Boldestfutura/tab-panel/tab-panel-bezel.stl

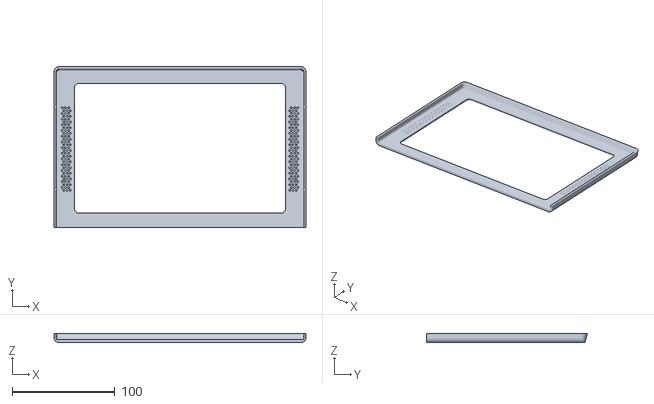
[picture p5: CAD file, 2026-10-31]
tab-panel-bezel.stl
245.0 x 156.4 x 9.00
