Boldestfutura/tab-panel/tab-panel-coupon.stl

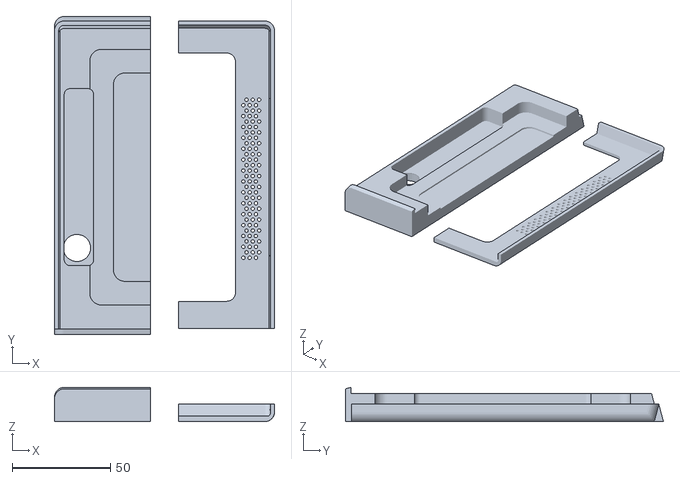
[picture p6: CAD file, 2026-10-31]
tab-panel-coupon.stl
112.0 x 161.7 x 17.5
