Boldestfutura/tab-panel/tab-panel-body.stl

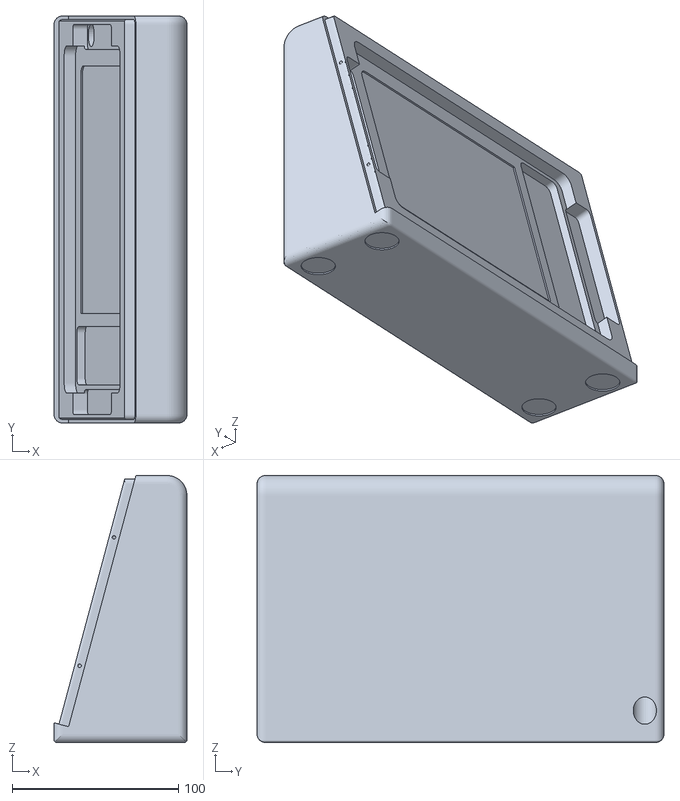
[picture p7: CAD file, 2026-10-31]
tab-panel-body.stl
80.0 x 245.0 x 160.8
