Boldestfutura/tab-panel/tab-panel-foot.stl

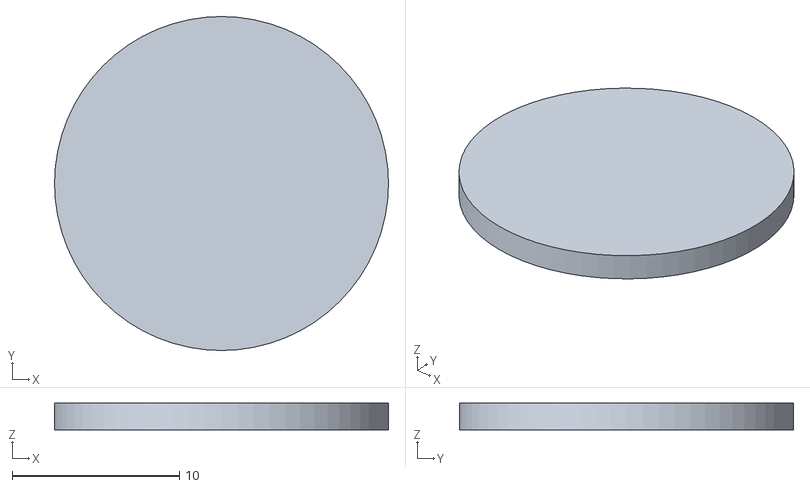
[picture p8: CAD file, 2026-10-31]
tab-panel-foot.stl
20.0 x 20.0 x 1.60
