Boldestfutura/tab-panel/(list of files, cad)

Other CAD files:
tab-panel.scad
