Boldestfutura/tab-panel/(commit log)

2026-10-25 Bench dock for a Waveshare 10.1" DSI panel — Rev M
    One printed body holding a 10.1-DSI-TOUCH-A at 15 degrees with a Raspberry Pi
    sealed inside. 246 x 158 x 78 mm, 249 cm3, watertight.
    Panel geometry is measured off the vendor's STEP rather than taken from the
    product page, which publishes none of it: glass 239.00 x 147.00 as the
    outermost AND largest layer, a flange 2.78 mm off the glass centre, and M2.5
    threads rather than M3. A stepped pocket is impossible here because the
    sub-bezel behind the glass is narrower than the flange behind it.
    The back is closed, which works because the Pi clears it with 25.2 mm behind
    the panel against a 22.4 mm stack. The flanks taper 10 mm a side from 18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
    [dock.scad, panel-stand-foot.stl, rev-m-coupon.stl, rev-m-dock-half.stl, rev-m-dock.stl, stand.scad]
2026-10-26 Rev N: split into body and removable cover
    Rev M passed every check and could not be built:
    - the panel screws in from behind and the back was sealed; the top
    two tabs had 7 mm of air behind them
    - the right bulkhead sat 1.2 mm behind the panel, through the Pi board
    - base-down, the edge above the screen was a 230 mm ceiling held only
    at its ends
    The back, top and the strip above the screen are now one cover held by
    four M3 thread-forming screws into bulkhead bosses. The body's front is
    a U with nothing to bridge. Bulkheads move to +-75 mm, top tabs get a
    45 degree web to the side wall, and the flange opening stops at the tab
    faces instead of shaving them to 2.5 mm.
    Also: cable slot c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
    [dock.scad, rev-m-coupon.stl, rev-m-dock-half.stl, rev-m-dock.stl, rev-n-body.stl, rev-n-coupon.stl, rev-n-cover.stl]
2026-10-27 Fork the pi-panel dock for a Lenovo Tab P11 (2nd Gen)
    Same body as Rev N; the panel opening, tabs, Pi cavity and cover are
    replaced by a flush pocket with a relieved floor, two side bays for the
    right-angle USB-C plug and the edge speakers, and an open cable path
    through the lip and under the base. 301 mm wide, so it prints as two
    halves pinned and glued on a solid seam wall.
    [dock.scad, panel-stand-foot.stl, rev-n-body.stl, rev-n-coupon.stl, rev-n-cover.stl, stand.scad, tab-dock-coupon.stl, tab-dock-left.stl]
2026-10-27 Export the right half beside the left, not over it
    The first export overlapped the halves and Orca merged them into one
    object. Side by side they share one plate at 192 x 150.
    [dock.scad, tab-dock-right.stl]
2026-10-28 Rev B: bezel, hidden chambers, magnetic power, 17 degree lean
    The open side bays become chambers behind a 1.2 mm bezel skin. The
    edge speakers vent through grilles in each flank, and the port-side
    chamber holds an Adafruit 5521 magnetic right-angle adapter, so the
    tablet snaps onto power as it drops in. The cable runs down the chamber
    and through a duct to an exit low on the back; a web under the duct
    keeps it printable. The glass now sits 2 mm under the face, a finger
    scoop replaces the bays as the grip, and a 0.8 mm reveal groove turns
    the seam into a parting line.
    The adapter's size is not published; its parameters are estimates
    until measured. The coupon is now the port-side chamber, pr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
    [dock.scad, tab-dock-coupon.stl, tab-dock-left.stl, tab-dock-right.stl]
2026-10-28 Push to release, slot grilles, keyed seam
    The finger scoop is gone. The bottom rim is cut 1.5 mm below the rest,
    so pressing the tablet's bottom edge pivots it on the side rims' lower
    ends and tips the top ~20 mm out of the pocket.
    The flank grilles are slots running up the face instead of round
    holes: upright, each slot's top bridges 2.2 mm. The coupon, printed
    flat, leaves them out.
    The three dowel pins become two 45-degree key ribs on the left half,
    one up the face and one along the base, with matching grooves in the
    right half, so the halves only go together one way. The seam wall is
    6 mm to take the grooves. part="keyfit" proves the rib and groove
    only meet on the seam face.
    Co-Autho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
    [dock.scad, tab-dock-coupon.stl, tab-dock-left.stl, tab-dock-right.stl]
2026-10-28 Unbroken bezel: slide to dock instead of a nub notch
    The notch in the port-side bezel was the magnetic nub's way in and
    out. It is gone; the tablet slides instead. A 3 mm recess under the
    far bezel, the full height of the pocket, takes the far end tucked in
    while the port end is lowered with the nub clear, then the tablet
    slides across and the magnet snaps on. To remove it, slide it back to
    part the magnet, then press the bottom edge to tip it out.
    part="slide" (the tablet slid away with the nub's path down from in
    front) and part="nubfit" (the nub with the tablet home) must both
    come out empty.
    [dock.scad, tab-dock-coupon.stl, tab-dock-left.stl, tab-dock-right.stl]
2026-10-28 Retarget to the Legion Tab 8.8 (Gen 3); print in one piece
    The 11-inch Tab P11 was too big beside a 7-inch Nest Hub. The Legion
    Tab (Gen 3) is 208.54 x 129.46 x 7.79 mm per Lenovo PSREF, with its
    charging USB-C centred on the right-hand short edge, where the
    magnetic adapter already sits, so the layout carries over unchanged.
    At 246 mm wide the dock now fits the P2S's 256 mm bed, so the split,
    the key ribs, the seam wall and the reveal groove are gone: one piece,
    base down, no supports. base_d 92 -> 80 for the shorter dock. Every
    fit check (fit, adapter, slide, nubfit) still comes out empty.
    [dock.scad, tab-dock-coupon.stl, tab-dock-left.stl, tab-dock-right.stl, tab-dock.stl]
2026-10-28 Recess for the rear camera bump
    The Legion Tab's camera module sits in the top-left corner (seen from
    the screen) and overlaps the top and left rims, so the tablet would have
    rested on it and rocked. Lenovo doesn't dimension it; scaled off the
    PSREF overview's edge views it is about 46 x 29 mm, 1.6-1.9 mm proud.
    The pocket gets a recess 2.6 mm below the rim, 5 mm bigger than the
    bump all round, and front_t grows so the wall behind it stays 2.4 mm.
    The tablet model now carries the bump, so fit and slide check it too;
    both still come out empty.
    [dock.scad, tab-dock-coupon.stl, tab-dock.stl]
2026-10-30 Retarget to the ALLDOCUBE iPlay 80 mini Turbo
    208.2 x 129.2 x 6.95 mm. The port moves to the left: the keys sit on a
    long edge near the camera end, and port-right would stand the tablet on
    its power key. The camera is a full-height bar at the right end, so it
    gets a 5.2 mm recess and an 8 mm rib inboard of it takes the rim's job.
    The slide recess now starts 0.05 mm behind the skin: level with the
    chamber faces, the two cuts crossed and left the STL non-manifold.
    Camera, speaker and key positions come from product photos, not a
    tablet. The Legion version is tagged legion-tab-8.8.
    [dock.scad, tab-dock-coupon.stl, tab-dock.stl]
2026-10-31 Echo Show-style enclosure for the iPlay 80 mini Turbo
    An experiment beside the slide-in dock, after the Echo Show enclosure
    on Printables: a soft-cornered block and a separate bezel that snaps
    onto a tenon round the face and laps the glass to hold the tablet.
    Speaker grilles in the bezel over the edge chambers, a sideways
    right-angle USB-C in the left chamber with a duct to the back, and
    four TPU feet.
    Body, bezel and coupon are manifold; fit, plugfit and mate come out
    empty; worst reach over air is 9.9 mm on the body, 0.6 on the bezel.
    [dock.scad, echo-bezel.stl, echo-body.stl, echo-coupon.stl, echo-foot.stl, enclosure.scad, tab-dock-coupon.stl, tab-dock.stl]
2026-10-31 Make the Echo-style enclosure the tab-panel
    The slide-in dock is retired and kept as tag slide-dock. Files renamed
    from echo-* and enclosure.scad to tab-panel-* and tab-panel.scad; the
    README drops the experimental framing and points at the old tags.
    [tab-panel-bezel.stl, tab-panel-body.stl, tab-panel-coupon.stl, tab-panel-foot.stl, tab-panel.scad]
2026-10-31 Add TODO.md: what to measure on the real tablet, then next steps
    Every dimension past the headline size is from product photos. The
    list maps each measurement to its setting in tab-panel.scad, adds the
    mics, front camera, buttons, screen offset and edge profile, and the
    cable, then the coupon and print steps.
